lucaregianini/esp32c3-findmy-tracker/case/c3_tracker_back.stl

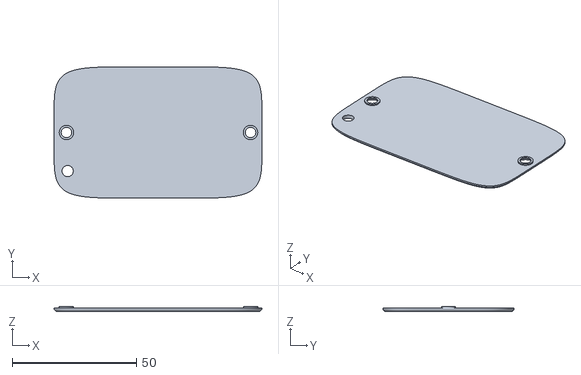
[picture p3: CAD file, 2026-09-26]
case/c3_tracker_back.stl
83.6 x 52.8 x 1.90
