lucaregianini/esp32c3-findmy-tracker/case/print/C3 Tracker - Shell (white + red stripe).3mf

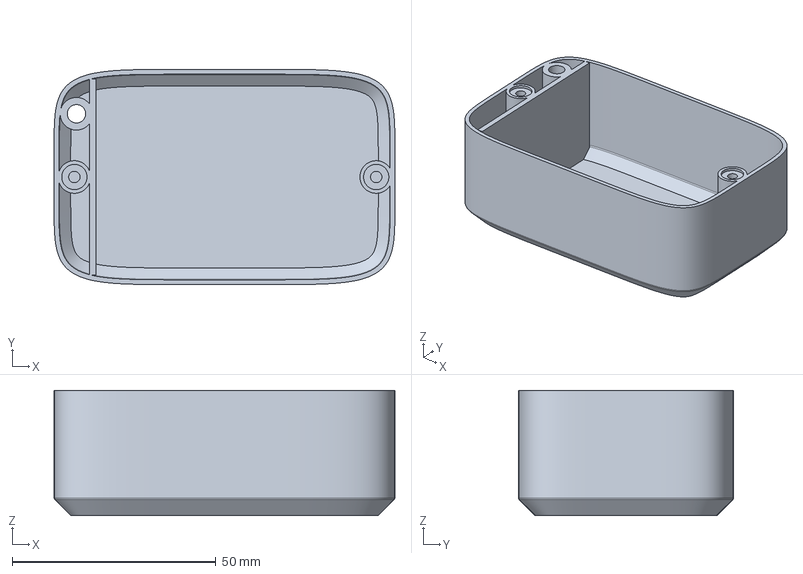
[picture p4: CAD file, 2026-09-26]
case/print/C3 Tracker - Shell (white + red stripe).3mf
83.6 x 52.8 x 30.7 mm
