lucaregianini/esp32c3-findmy-tracker/(list of files, cad)

Other CAD files:
case/c3_tracker_shell.stl
case/print/C3 Tracker - Back (white).3mf
