lucaregianini/esp32c3-findmy-tracker/case/previews/assembled_back.png

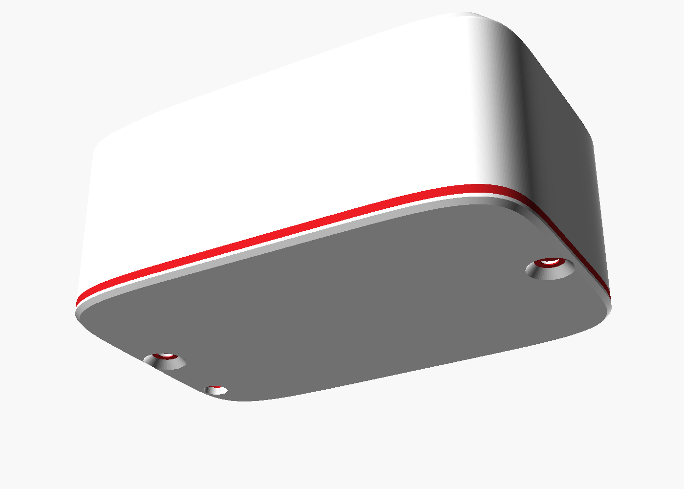
case/previews/assembled_back.png
